jvsalo/footswitch/misc/bom.ods

Part | Cost | Pcs | Code | Link | Datasheet
ATMEGA328P | 1,94 | 1 | ATMEGA328P-AU | https://www.digikey.fi/product-detail/en/microchip-technology/ATMEGA328P-AU/ATMEGA328P-AU-ND/1832260 | http://www.atmel.com/images/Atmel-8271-8-bit-AVR-Microcontroller-ATmega48A-48PA-88A-88PA-168A-168PA-328-328P_datasheet_Complete.pdf
N-channel MOSFET | 0,3 | 2 | BSS214NWH6327XTSA1 | https://www.digikey.fi/product-detail/en/infineon-technologies/BSS214NWH6327XTSA1/BSS214NWH6327XTSA1CT-ND/6134223 | http://www.infineon.com/dgdl/Infineon-BSS214NW-DS-v02_02-en.pdf?fileId=db3a30431b3e89eb011b695aebc01bde
2x4 bit OR | 0,38 | 1 | CD4072BM96 | https://www.digikey.fi/product-detail/en/texas-instruments/CD4072BM96/296-31518-1-ND/3505798 | http://www.ti.com/lit/ds/symlink/cd4071b.pdf
Mom-Off-Mom switch | 2,53 | 1 | 100SP4T1B1M1QEH | https://www.digikey.fi/product-detail/en/e-switch/100SP4T1B1M1QEH/EG2388-ND/378857 | http://spec_sheets.e-switch.com/specs/ST114005.pdf
Off-Mom switch | 1,06 | 10 | PS1024ABLK | https://www.digikey.fi/product-detail/en/e-switch/PS1024ABLK/EG2011-ND/81742 | https://media.digikey.com/pdf/Data%20Sheets/E-Switch%20PDFs/PS1024ARED.pdf
Led display | 2,19 | 1 | LDD-C514RI | https://www.digikey.fi/product-detail/en/lumex-opto-components-inc/LDD-C514RI/67-1458-ND/252617 | http://www.lumex.com/content/files/ProductAttachment/LDD-C514RI.pdf
Crystal | 0,59 | 1 | ABM3-8.000MHZ-D2Y-T | https://www.digikey.fi/product-detail/en/abracon-llc/ABM3-8.000MHZ-D2Y-T/535-10630-1-ND/2344632 | http://www.abracon.com/Support/PackageDrawing/Resonators/ABM3.PDF
