jvsalo/footswitch/kicad/footswitch.kicad_pcb

## KiCad design kicad/footswitch.kicad_pcb (2017-05-25)

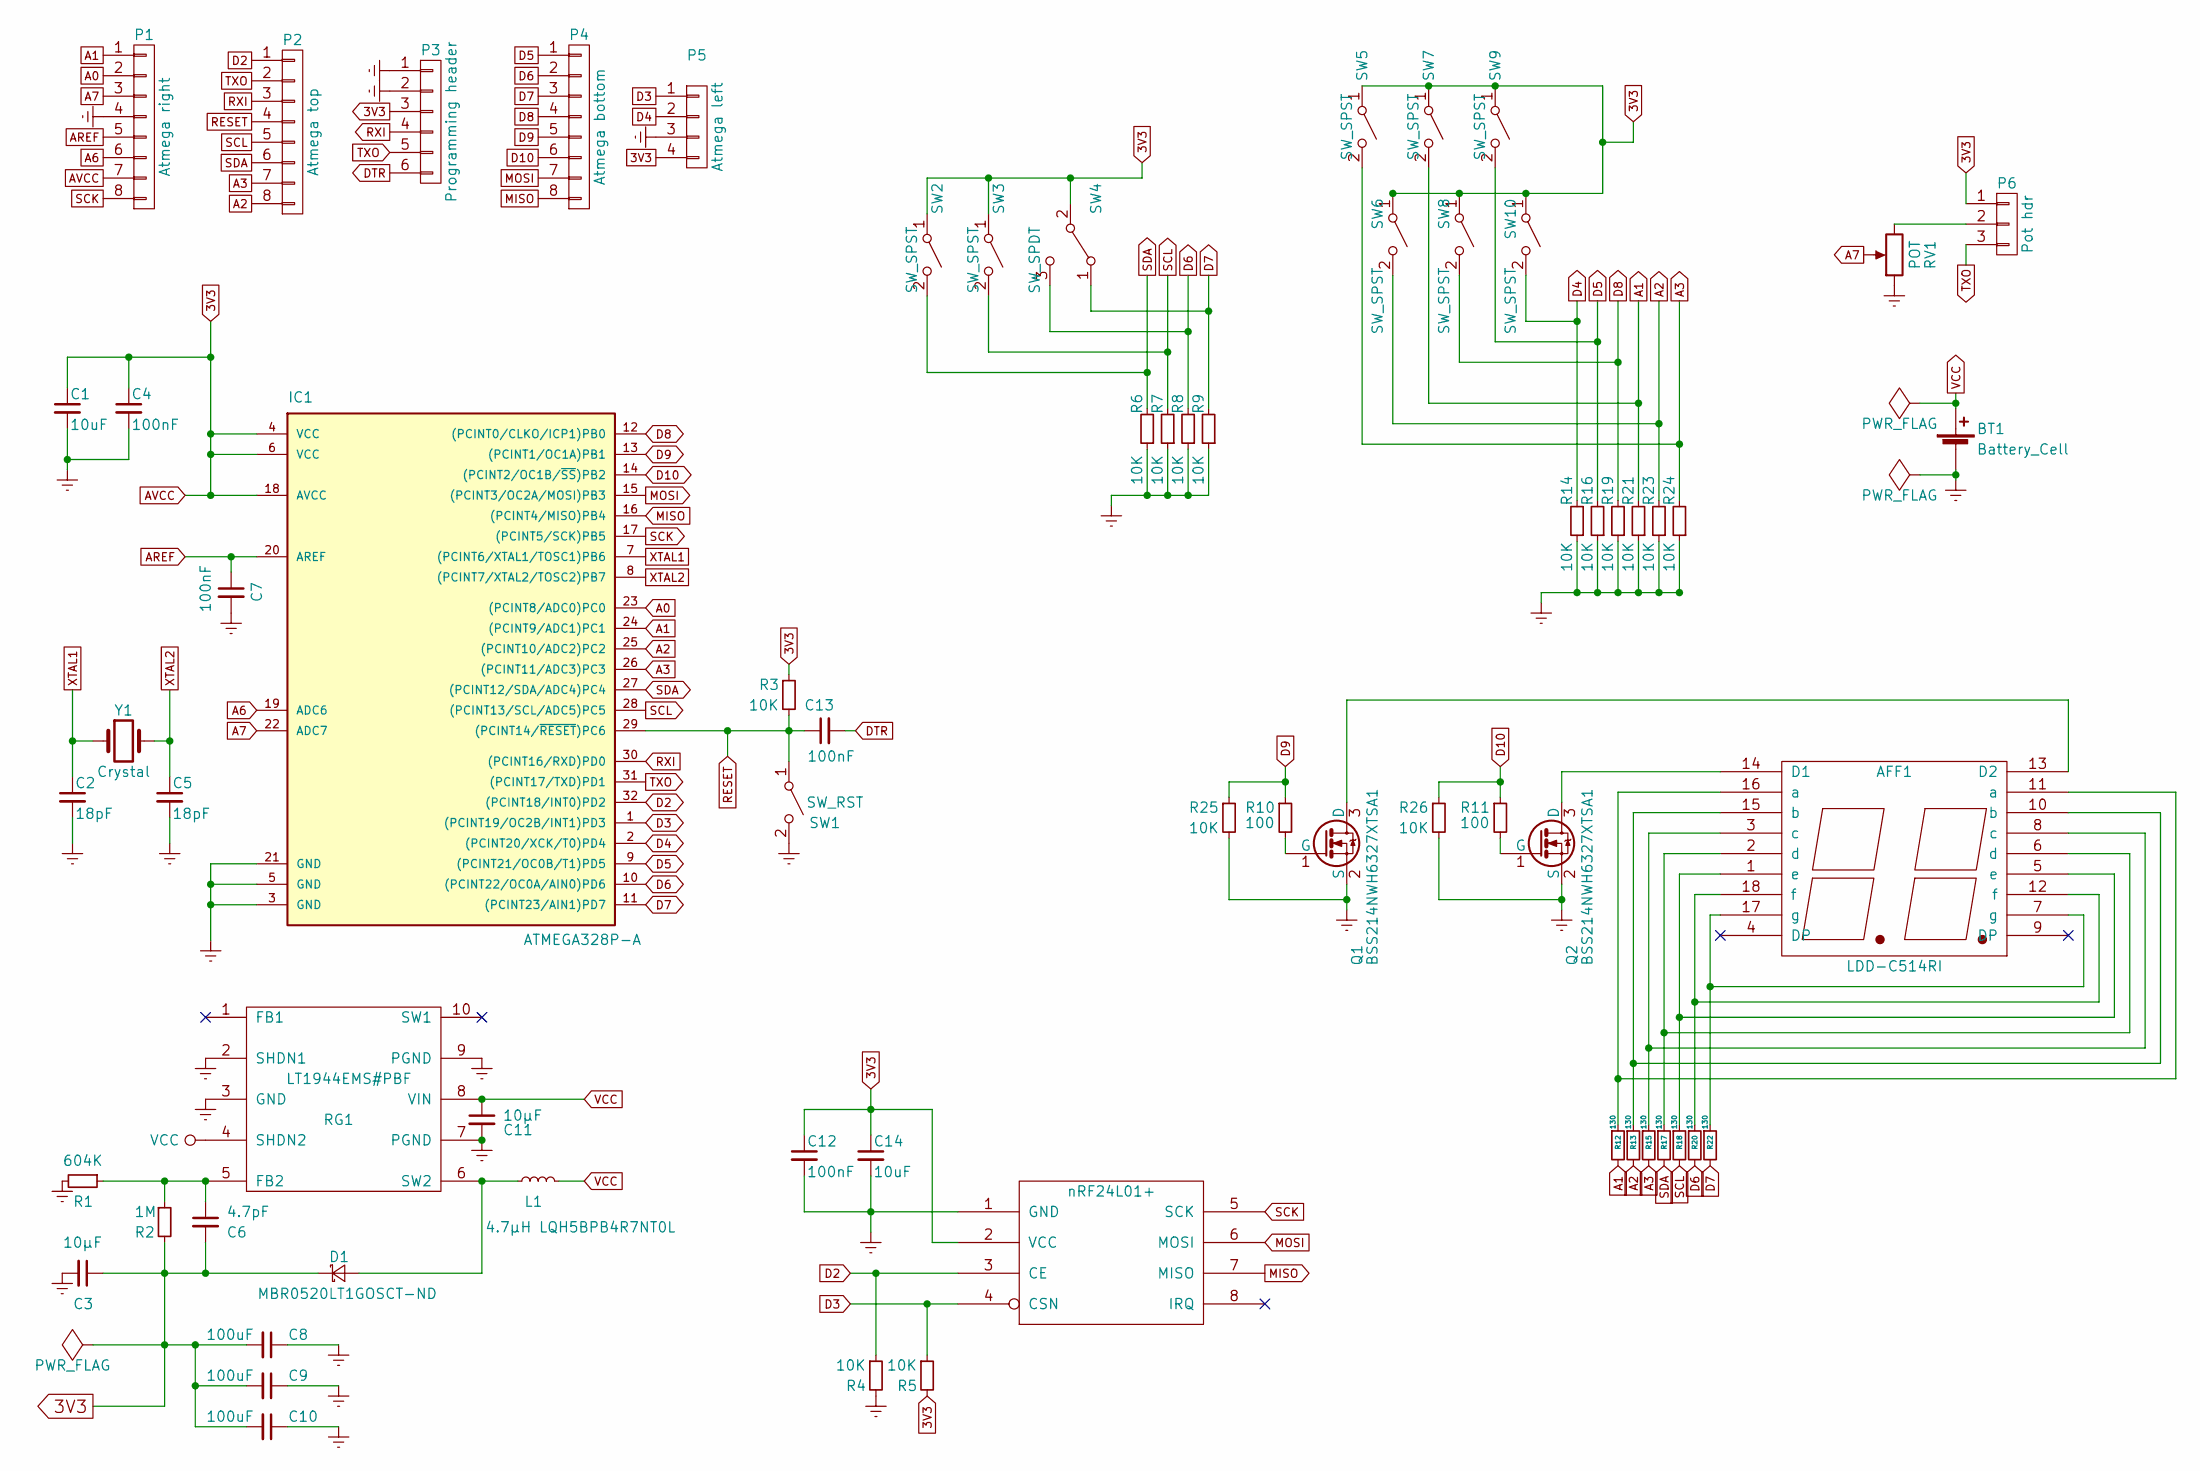
[picture p1: schematic footswitch.sch, MIDI footswitch]

Parts:
AFF1: LDD-C514RI; DA56
BT1: Battery_Cell; Pin_Header_Straight_1x02_Pitch2.54mm
C1, C14: 10uF; C_1206_HandSoldering
C2, C5: 18pF; C_1206_HandSoldering
C3, C11: 10µF; C_1206_HandSoldering
C4, C7, C12, C13: 100nF; C_1206_HandSoldering
C6: 4.7pF; C_1206_HandSoldering
C8, C9, C10: 100uF; C_1206_HandSoldering
D1: MBR0520LT1GOSCT-ND; D_SOD-123
IC1: ATMEGA328P-A; TQFP-32_7x7mm_Pitch0.8mm
L1: 4.7µH LQH5BPB4R7NT0L; Inductor_Taiyo-Yuden_NR-50xx_HandSoldering
P1: Atmega right; Pin_Header_Straight_1x08_Pitch2.54mm
P2: Atmega top; Pin_Header_Straight_1x08_Pitch2.54mm
P3: Programming header; Pin_Header_Straight_1x06_Pitch2.54mm
P4: Atmega bottom; Pin_Header_Straight_1x08_Pitch2.54mm
P5: Atmega left; Pin_Header_Straight_1x04_Pitch2.54mm
P6: Pot hdr; Pin_Header_Straight_1x03_Pitch2.54mm
Q1, Q2: BSS214NWH6327XTSA1; SOT-323_SC-70_Handsoldering
R1: 604K; R_1206_HandSoldering
R2: 1M; R_1206_HandSoldering
R3, R4, R5, R6, R7, R8, R9, R14, R16, R19, R21, R23, R24, R25, R26: 10K; R_1206_HandSoldering
R10, R11: 100; R_1206_HandSoldering
R12, R13, R15, R17, R18, R20, R22: 130; R_1206_HandSoldering
RG1: LT1944EMS#PBF; MSOP-10_3x3mm_Pitch0.5mm
RV1: POT; Pin_Header_Straight_1x03_Pitch2.54mm
SW1: SW_RST; SW_SPST_B3S-1000
SW2, SW3, SW5, SW6, SW7, SW8, SW9, SW10: SW_SPST; Pin_Header_Straight_1x02_Pitch2.54mm
SW4: SW_SPDT; Pin_Header_Straight_1x03_Pitch2.54mm
U1: nRF24L01+; NRF24L01
Y1: Crystal; Crystal_SMD_Abracon_ABM3-2pin_5.0x3.2mm_HandSoldering

Connections:
3V3: C1.1, C3.1, C4.1, C6.2, C8.2, C9.2, C10.2, C12.1, C14.1, D1.1 (K), IC1.4 (VCC), IC1.6 (VCC), IC1.18 (AVCC), P1.7, P3.3, P5.4, P6.1, R2.2, R3.1, R5.2, SW2.1 (A), SW3.1 (A), SW4.2 (B), SW5.1 (A), SW6.1 (A), SW7.1 (A), SW8.1 (A), SW9.1 (A), SW10.1 (A), U1.2 (VCC)
A0: IC1.23 ((PCINT8/ADC0)PC0), P1.2
A1: IC1.24 ((PCINT9/ADC1)PC1), P1.1, R12.2, R21.2, SW7.2 (B)
A2: IC1.25 ((PCINT10/ADC2)PC2), P2.8, R13.2, R23.2, SW6.2 (B)
A3: IC1.26 ((PCINT11/ADC3)PC3), P2.7, R15.2, R24.2, SW5.2 (B)
A6: IC1.19 (ADC6), P1.6
A7: IC1.22 (ADC7), P1.3, RV1.2
AREF: C7.1, IC1.20 (AREF), P1.5
D2: IC1.32 ((PCINT18/INT0)PD2), P2.1, R4.1, U1.3 (CE)
D3: IC1.1 ((PCINT19/OC2B/INT1)PD3), P5.1, R5.1, U1.4 (CSN)
D4: IC1.2 ((PCINT20/XCK/T0)PD4), P5.2, R14.2, SW10.2 (B)
D5: IC1.9 ((PCINT21/OC0B/T1)PD5), P4.1, R16.2, SW9.2 (B)
D6: IC1.10 ((PCINT22/OC0A/AIN0)PD6), P4.2, R8.2, R20.2, SW4.3 (C)
D7: IC1.11 ((PCINT23/AIN1)PD7), P4.3, R9.2, R22.2, SW4.1 (A)
D8: IC1.12 ((PCINT0/CLKO/ICP1)PB0), P4.4, R19.2, SW8.2 (B)
D9: IC1.13 ((PCINT1/OC1A)PB1), P4.5, R10.1, R25.1
D10: IC1.14 ((PCINT2/OC1B/~SS~)PB2), P4.6, R11.1, R26.1
DTR: C13.2, P3.6
Earth: BT1.2 (-), C1.2, C2.2, C3.2, C4.2, C5.2, C7.2, C8.1, C9.1, C10.1, C11.2, C12.2, C14.2, IC1.3 (GND), IC1.5 (GND), IC1.21 (GND), P1.4, P3.1, P3.2, P5.3, Q1.2 (S), Q2.2 (S), R1.2, R4.2, R6.1, R7.1, R8.1, R9.1, R14.1, R16.1, R19.1, R21.1, R23.1, R24.1, R25.2, R26.2, RG1.2 (SHDN1), RG1.3 (GND), RG1.7 (PGND), RG1.9 (PGND), RV1.1, SW1.2 (B), U1.1 (GND)
MISO: IC1.16 ((PCINT4/MISO)PB4), P4.8, U1.7 (MISO)
MOSI: IC1.15 ((PCINT3/OC2A/MOSI)PB3), P4.7, U1.6 (MOSI)
unnamed: AFF1.1 (e), AFF1.5 (e), R18.1
unnamed: AFF1.2 (d), AFF1.6 (d), R17.1
unnamed: AFF1.3 (c), AFF1.8 (c), R15.1
unnamed: AFF1.10 (b), AFF1.15 (b), R13.1
unnamed: AFF1.11 (a), AFF1.16 (a), R12.1
unnamed: AFF1.12 (f), AFF1.18 (f), R20.1
unnamed: AFF1.13 (D2), Q1.3 (D)
unnamed: AFF1.14 (D1), Q2.3 (D)
unnamed: AFF1.7 (g), AFF1.17 (g), R22.1
unnamed: C6.1, R1.1, R2.1, RG1.5 (FB2)
unnamed: D1.2 (A), L1.1, RG1.6 (SW2)
unnamed: P6.2, RV1.3
unnamed: Q1.1 (G), R10.2
unnamed: Q2.1 (G), R11.2
RESET: C13.1, IC1.29 ((PCINT14/~RESET~)PC6), P2.4, R3.2, SW1.1 (A)
RXI: IC1.30 ((PCINT16/RXD)PD0), P2.3, P3.4
SCK: IC1.17 ((PCINT5/SCK)PB5), P1.8, U1.5 (SCK)
SCL: IC1.28 ((PCINT13/SCL/ADC5)PC5), P2.5, R7.2, R18.2, SW3.2 (B)
SDA: IC1.27 ((PCINT12/SDA/ADC4)PC4), P2.6, R6.2, R17.2, SW2.2 (B)
TXO: IC1.31 ((PCINT17/TXD)PD1), P2.2, P3.5, P6.3
VCC: BT1.1 (+), C11.1, L1.2, RG1.4 (SHDN2), RG1.8 (VIN)
XTAL1: C2.1, IC1.7 ((PCINT6/XTAL1/TOSC1)PB6), Y1.1
XTAL2: C5.1, IC1.8 ((PCINT7/XTAL2/TOSC2)PB7), Y1.2

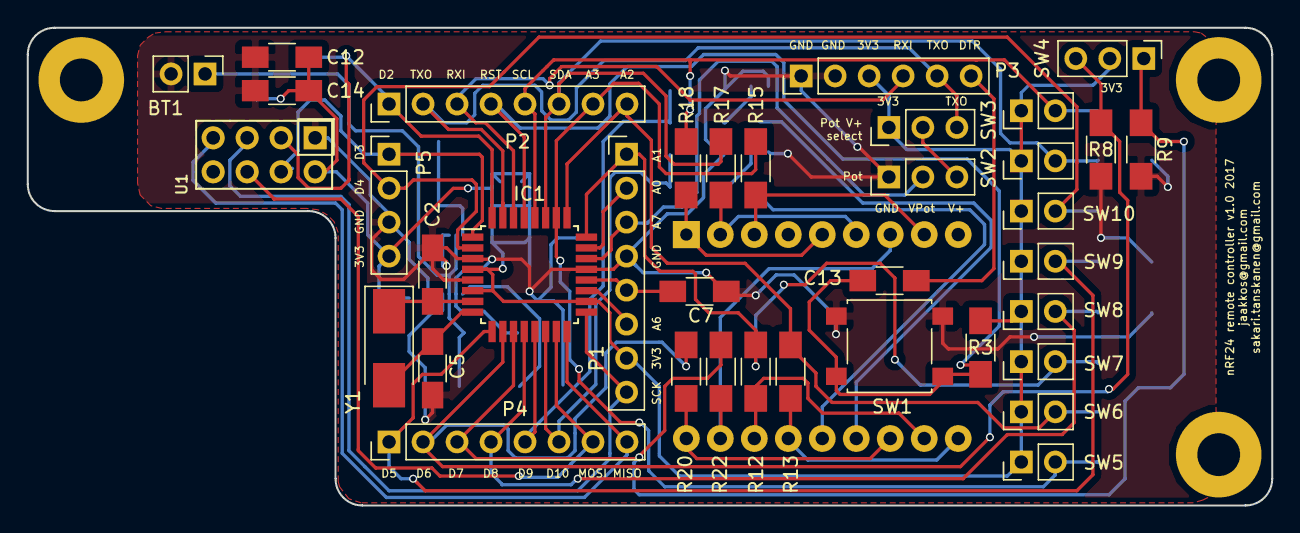
[picture p2: board footswitch.kicad_pcb from above]

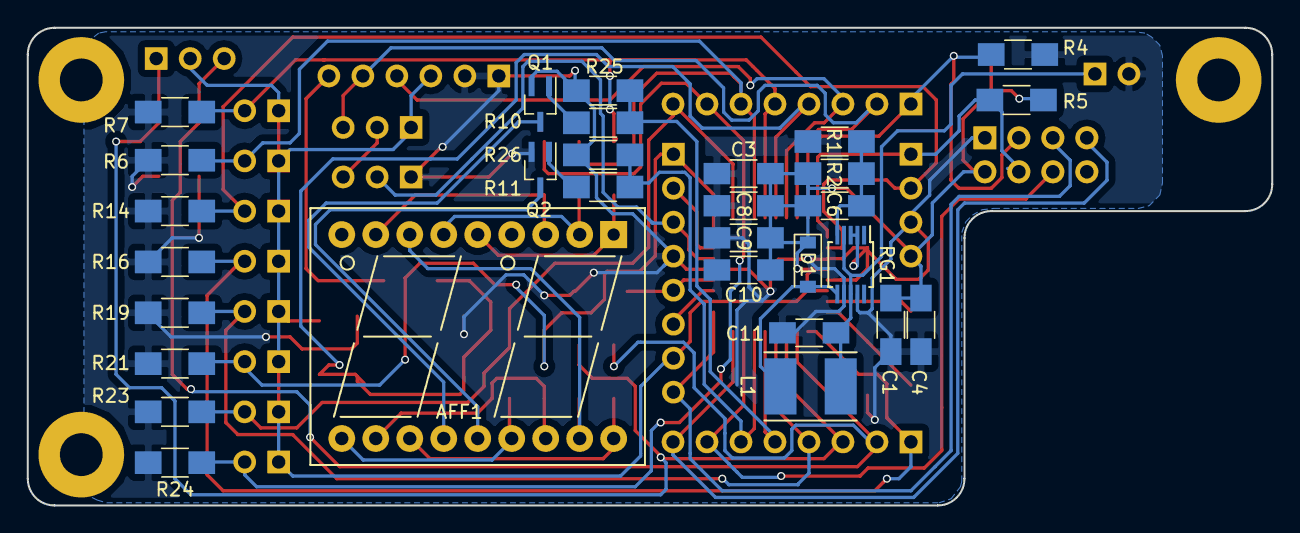
[picture p3: board footswitch.kicad_pcb from below]

Board: 2 copper layers, 93.0 x 35.7 mm, 67 parts (30 on the bottom side), 44 nets.
