jvsalo/footswitch/(threads)

Thread 1 (2017-06-04):

Race condition with footsw_pot_converge_left

jvsalo, 2017-06-04:
It's not guaranteed that footsw_pot_converge_left is reset when entering potentiometer_mode() when the potentiometer switch is first engaged. POT_SW_STATE_BIT would be set/read later, but bad things may already have happened in potentiometer_mode().

jvsalo, 2017-06-07:
This is a non-issue since footsw_pot_converge_left is reset when potentiometer mode is exited.

Closed 2017-06-07.
