jvsalo/footswitch/(commit log)

2017-04-11 Start schematic
    [bom.ods, footswitch.kicad_pcb, footswitch.sch]
2017-04-11 Add boost converter
    [footswitch.sch]
2017-04-13 Continue schematic
    [bom.ods, footswitch.sch]
2017-04-14 Add battery holder footprint
2017-04-14 Add radio footprints
2017-04-15 Finished schematic
    - finished schematic drawing
    - added schematic library for ldd-c514ri led display
    - added footprint for 100SP4T1B1M1QEH mom-off-mom switch
    - annotated footprints for components
    [bom.ods, footswitch.sch]
2017-04-15 Fix CD4072BM96 footprint
    [footswitch.sch]
2017-04-20 Fix bugs in schematic; start routing
    [footswitch.kicad_pcb, footswitch.sch]
2017-04-20 Continue routing
    [footswitch.kicad_pcb, footswitch.sch]
2017-04-21 Finish routing; markings and mounting still missing
    [footswitch.kicad_pcb, footswitch.sch]
2017-04-25 Remove OR gates; add version and authors to silk screen
    [footswitch.kicad_pcb, footswitch.sch]
2017-04-25 Move boost converter inductor away from under Atmega
    [footswitch.kicad_pcb]
2017-04-25 Add mounting holes
    [footswitch.kicad_pcb]
2017-04-26 Add silk screen markings
    [footswitch.kicad_pcb]
2017-05-01 Version 1.0
    [footswitch.kicad_pcb]
2017-05-25 Initial attempt at footswitch receiver code
    [footswitch.kicad_pcb]
2017-05-25 Misc. fixes
    - ADC6 and 7 have no digital IO on Atmega, change pins
    - Fix serial speed
    - Fix initialize printf library
    [receiver.ino]
2017-05-25 Fix whitespace and remove delay
    [receiver.ino]
2017-05-25 Misc. fixes
    - Add leading zeroes in hex printing
    - Set radio transfer rate
    - Fix message length and offset
    [receiver.ino]
2017-05-25 Fix MIDI optocoupler drive polarity
    [receiver.ino]
2017-05-27 Add button interrupts and sleep code
2017-05-27 Misc. changes
    - Add potentiometer reading with deadzone and lowpass filtering
    - Export button state from button int handler
2017-05-27 Prevent ADC flapping
2017-05-27 Misc. changes
    - Implement automatic sleep after 10 second idle
    - Handle potentiometer button
    - Add blinking to potentiometer control mode
    - Increase potentiometer change threshold
2017-05-28 Add LED intensity control
2017-05-28 Handle button events in all modes
    Button actions are never omitted regardless of mode.
2017-05-28 Introduce preset state and fix race
    [footswitch.ino]
2017-05-28 Implement button debounce
2017-05-28 Fade out LEDs before sleep
2017-05-28 Fix potentiometer dead zone
    [footswitch.ino]
2017-05-28 Implement radio TX fail animation
    [footswitch.ino]
2017-05-28 Try harder on RX fail; fix fail animation
    [footswitch.ino]
2017-05-28 Fix code to use full 7-bit volume range
    [footswitch.ino]
2017-05-28 Fix sleep code
    - Disable ADC, saves a lot of power
    - Properly unwind if sleep condition re-check fails
    [footswitch.ino]
2017-05-29 Change resistor values to 1M to conserve power
    [footswitch.sch]
2017-05-29 Use TX pin to power ADC
2017-05-30 Misc. changes
    - Display preset numbers like other MIDI controllers,
    ie. preset indexing starting from 1
    - Swap footswitch buttons to match current assembly
    - Change volume control to set the "hard" volume
    [footswitch.ino]
2017-06-04 Add missing volatile qualifiers
    [footswitch.ino]
